FranCodeCafe/MeteorinoPi/meteorino/imgs/graficos/velocidad.jpg

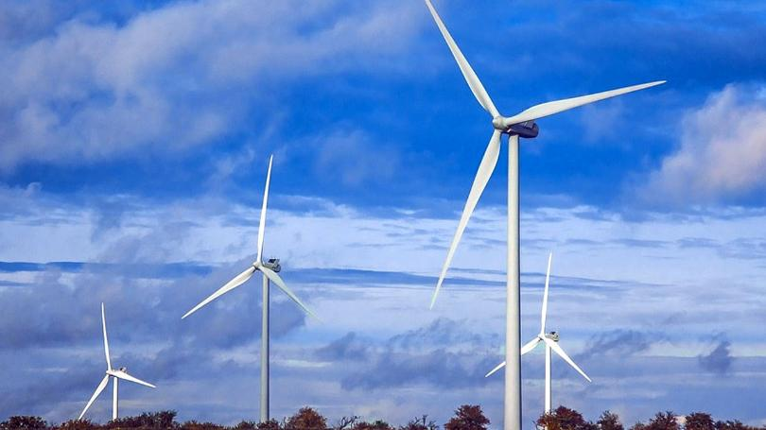
meteorino/imgs/graficos/velocidad.jpg
