FranCodeCafe/MeteorinoPi/Meteo_144458.png

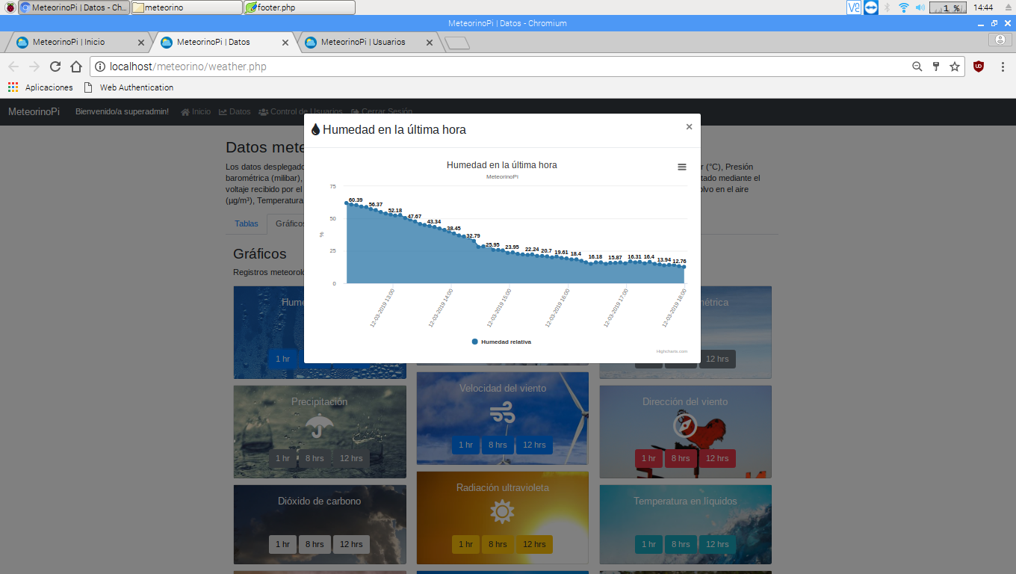
Meteo_144458.png
