FranCodeCafe/MeteorinoPi/Arduino1_1.jpg

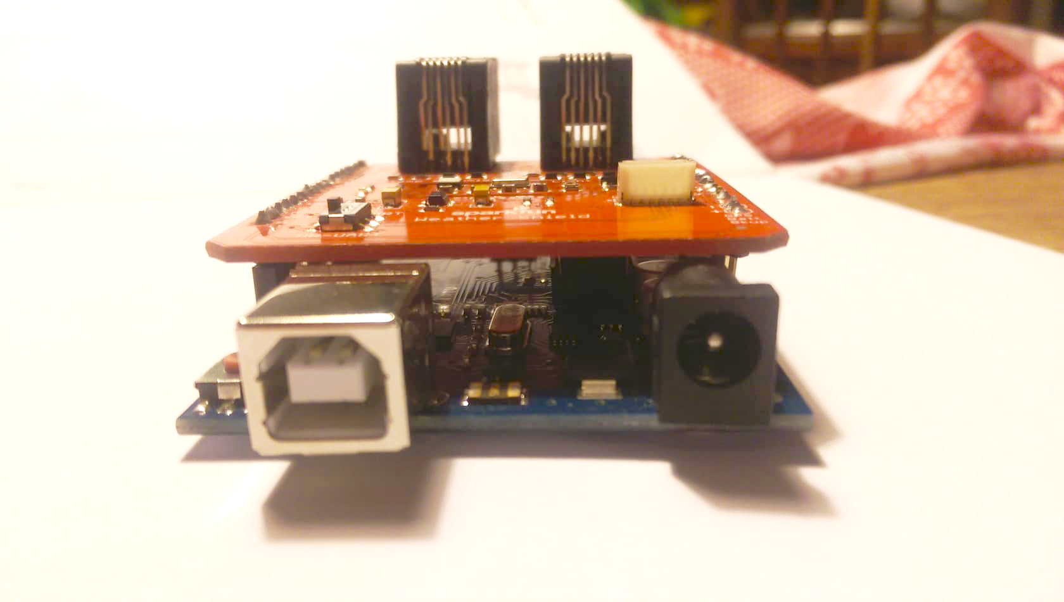
Arduino1_1.jpg
