FranCodeCafe/MeteorinoPi/Arduino1_2.jpg

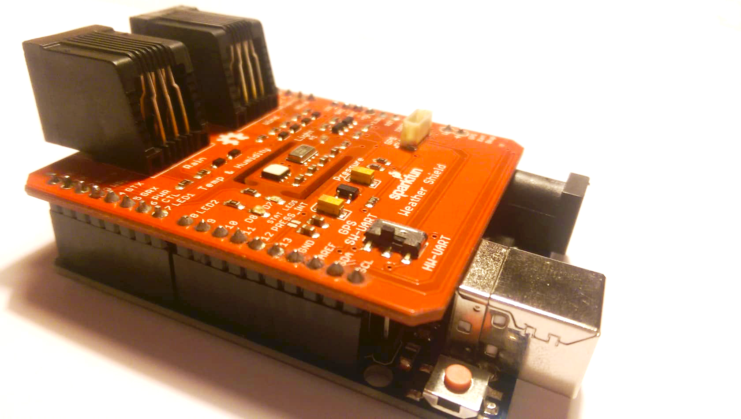
Arduino1_2.jpg
