FranCodeCafe/MeteorinoPi/Arduino2.png

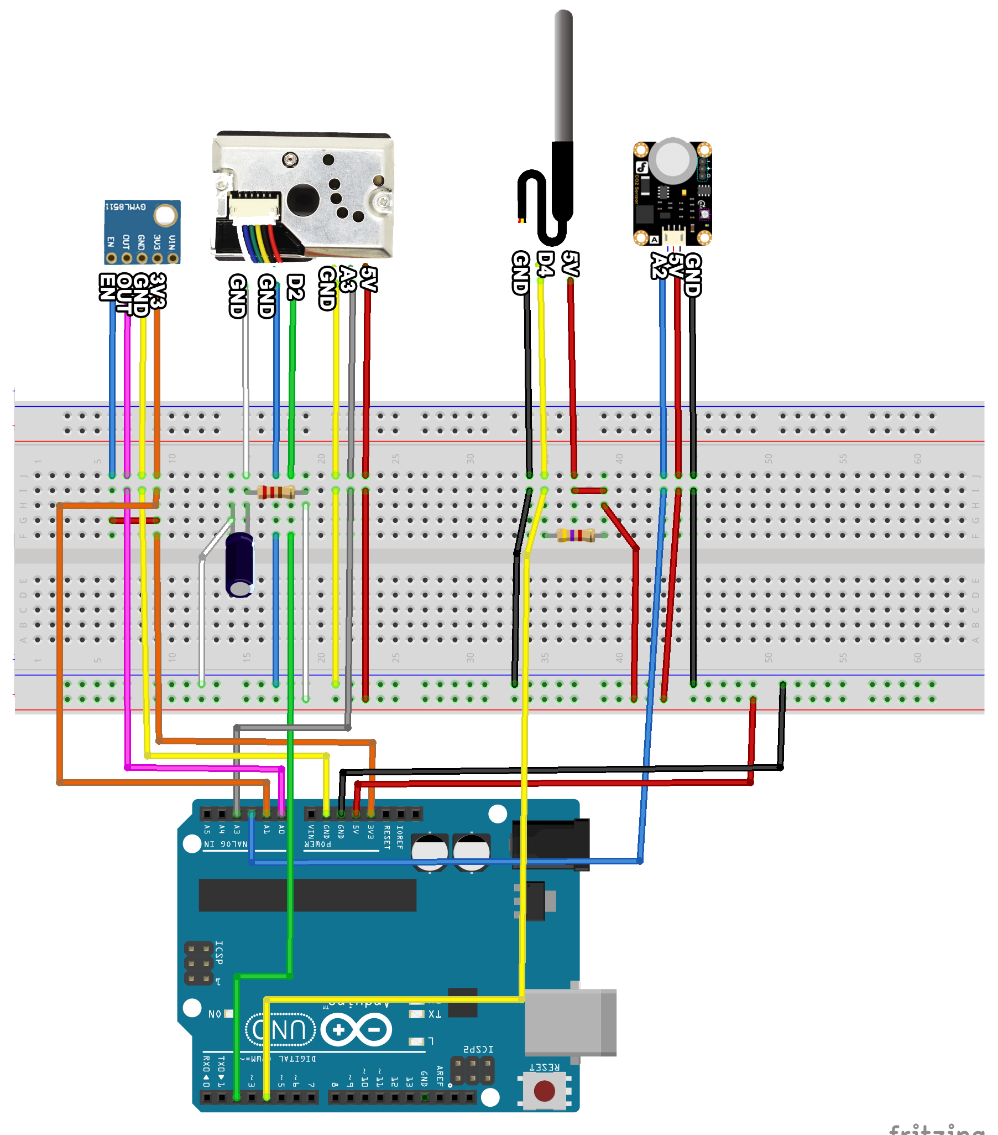
Arduino2.png
