FranCodeCafe/MeteorinoPi/Meteo_144257.png

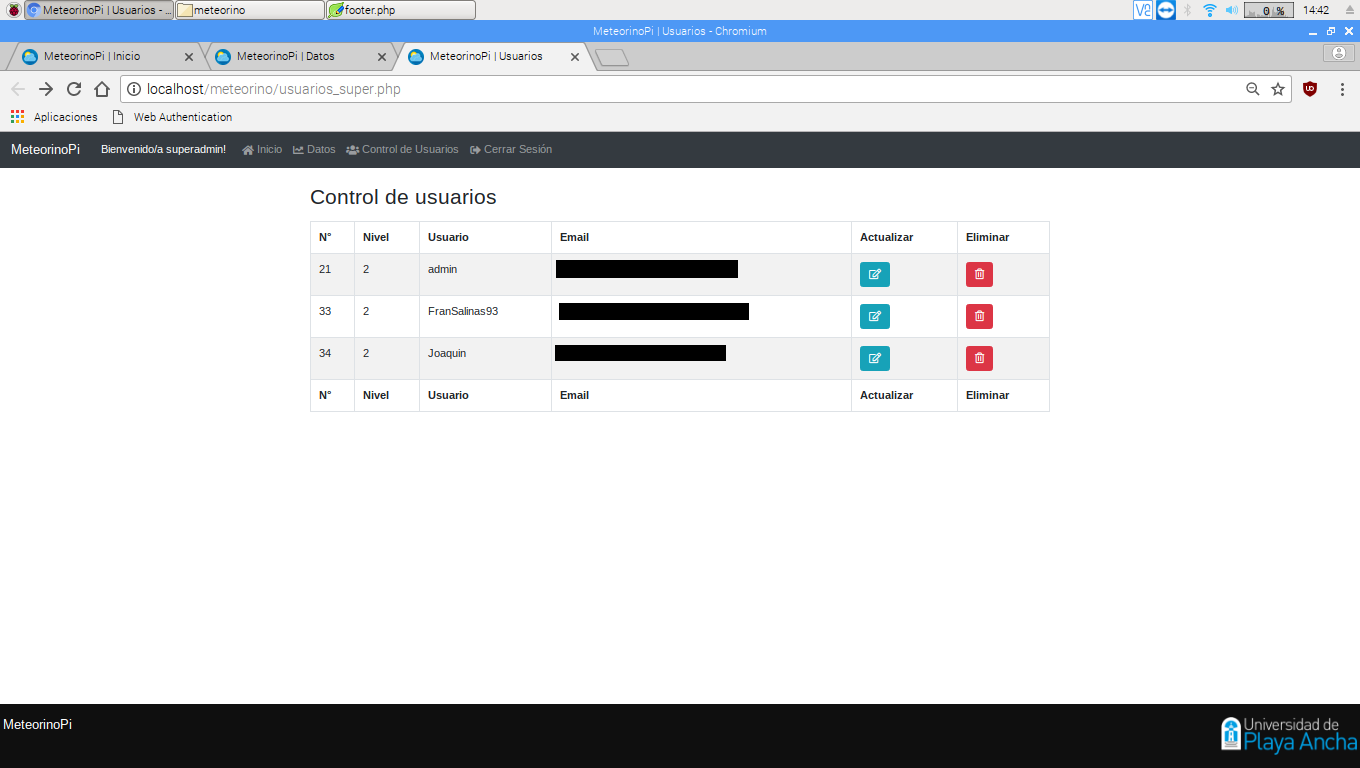
Meteo_144257.png
