FranCodeCafe/MeteorinoPi/Meteo_144417.png

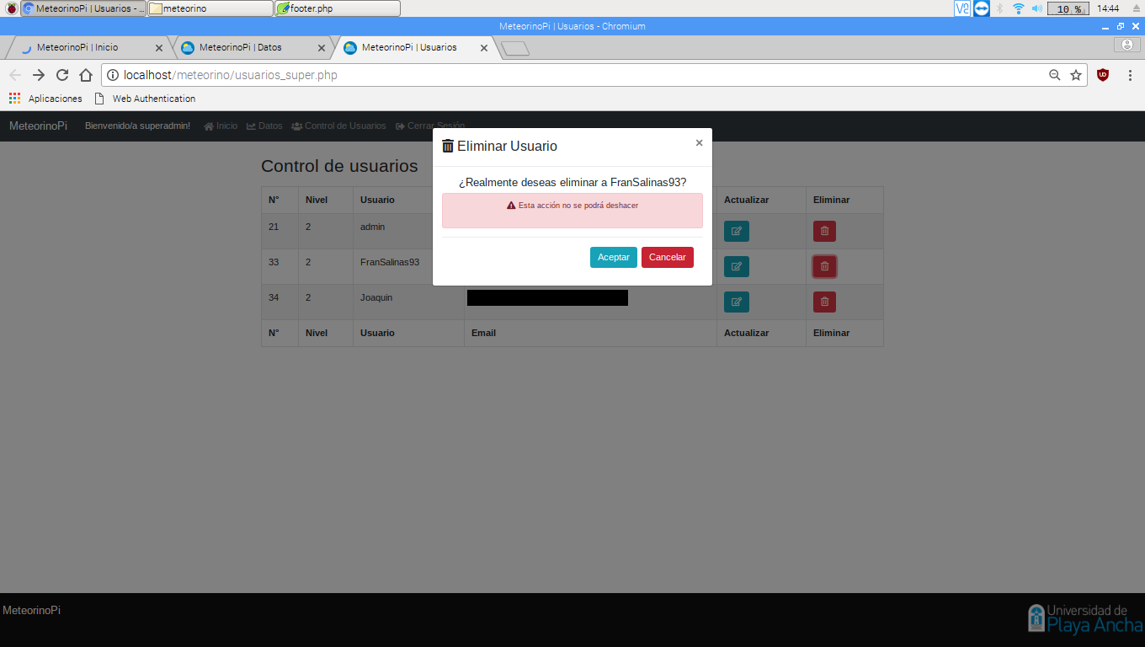
Meteo_144417.png
