FranCodeCafe/MeteorinoPi/Meteo_144430.png

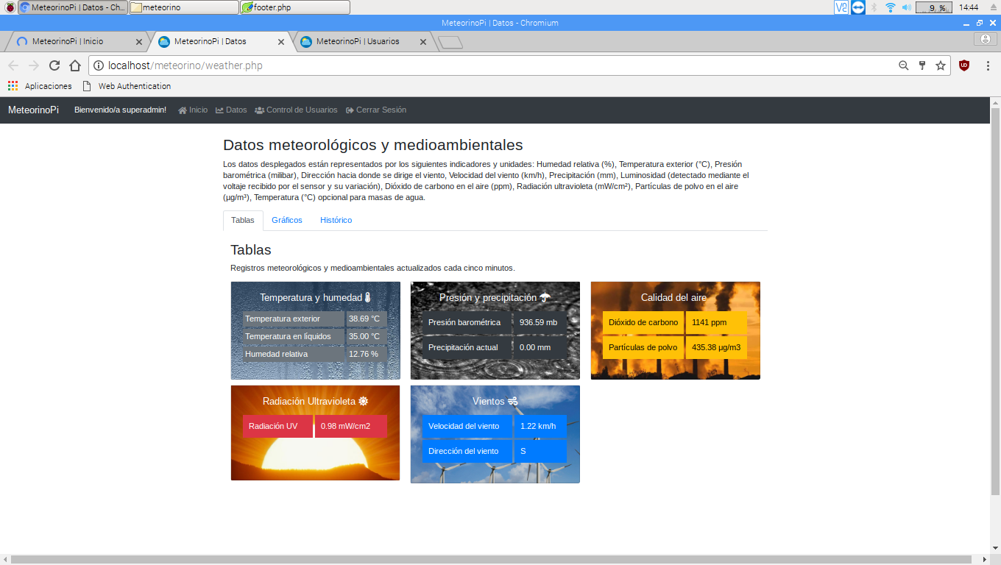
Meteo_144430.png
