FranCodeCafe/MeteorinoPi/Meteo_144438.png

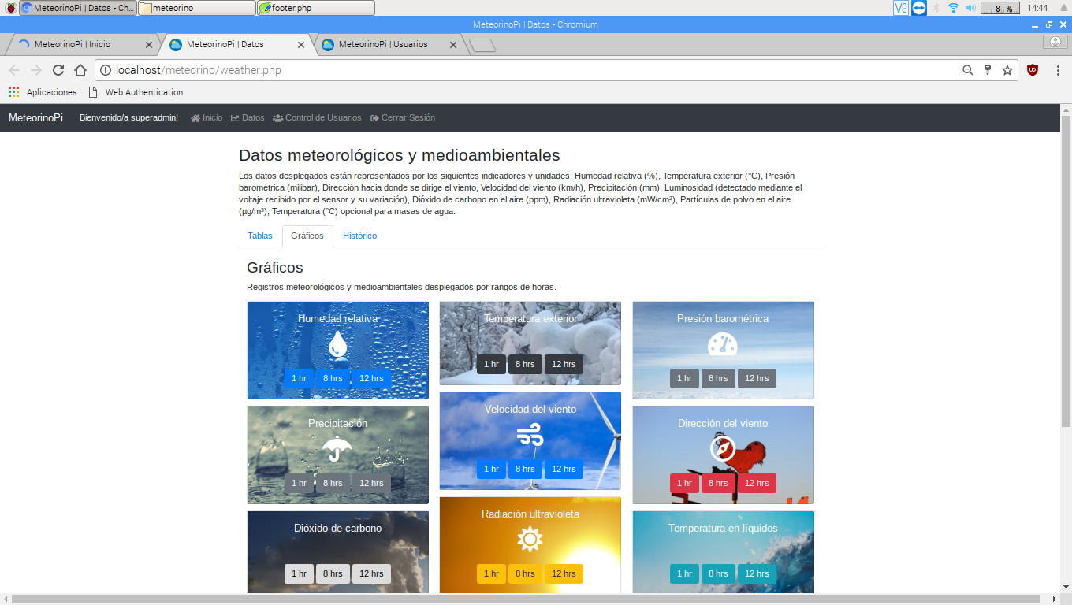
Meteo_144438.png
