FranCodeCafe/MeteorinoPi/Meteo_144442.png

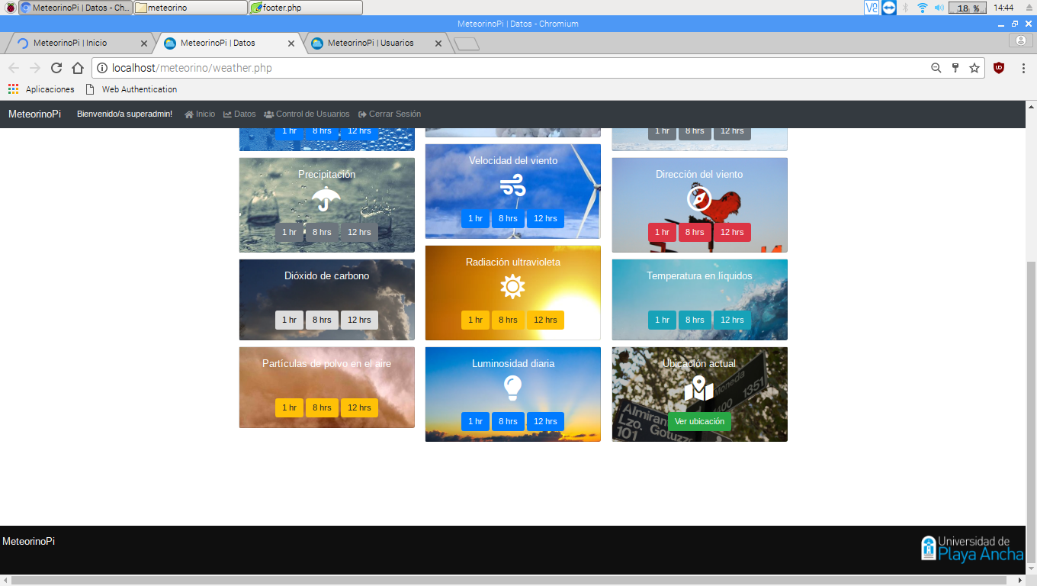
Meteo_144442.png
