FranCodeCafe/MeteorinoPi/Meteo_144524.png

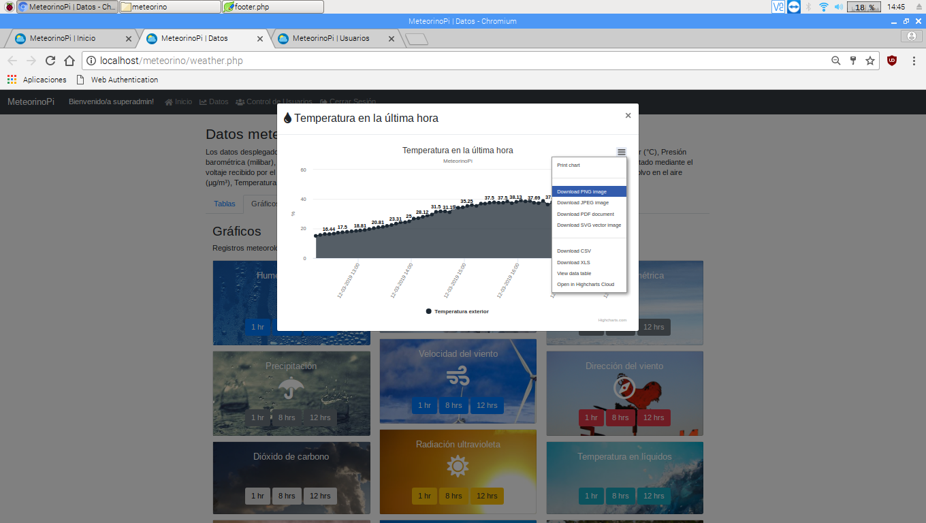
Meteo_144524.png
