FranCodeCafe/MeteorinoPi/Meteo_144529.png

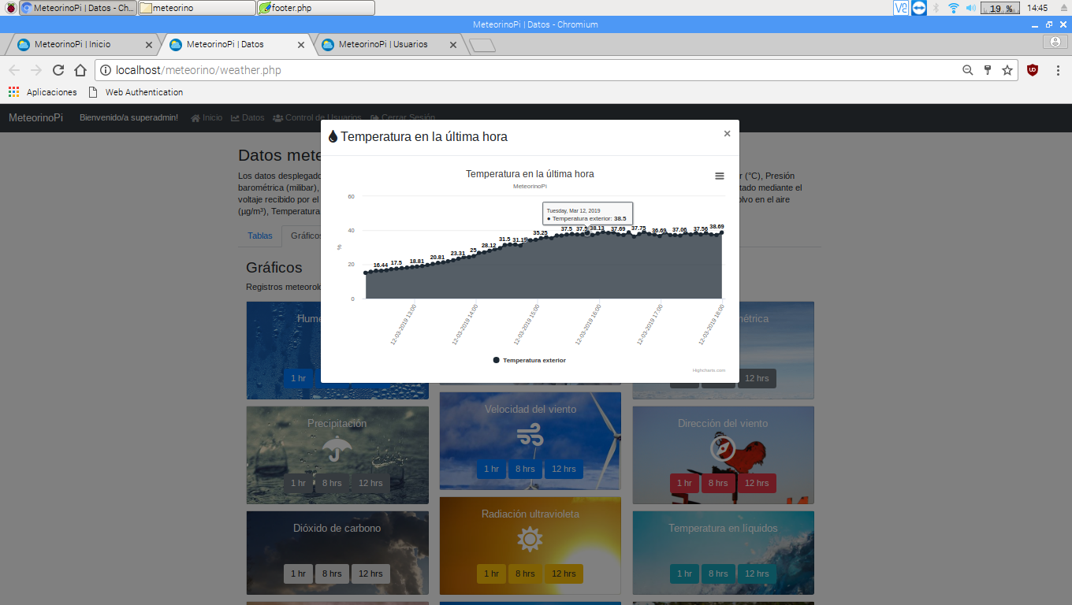
Meteo_144529.png
