FranCodeCafe/MeteorinoPi/Meteo_144618.png

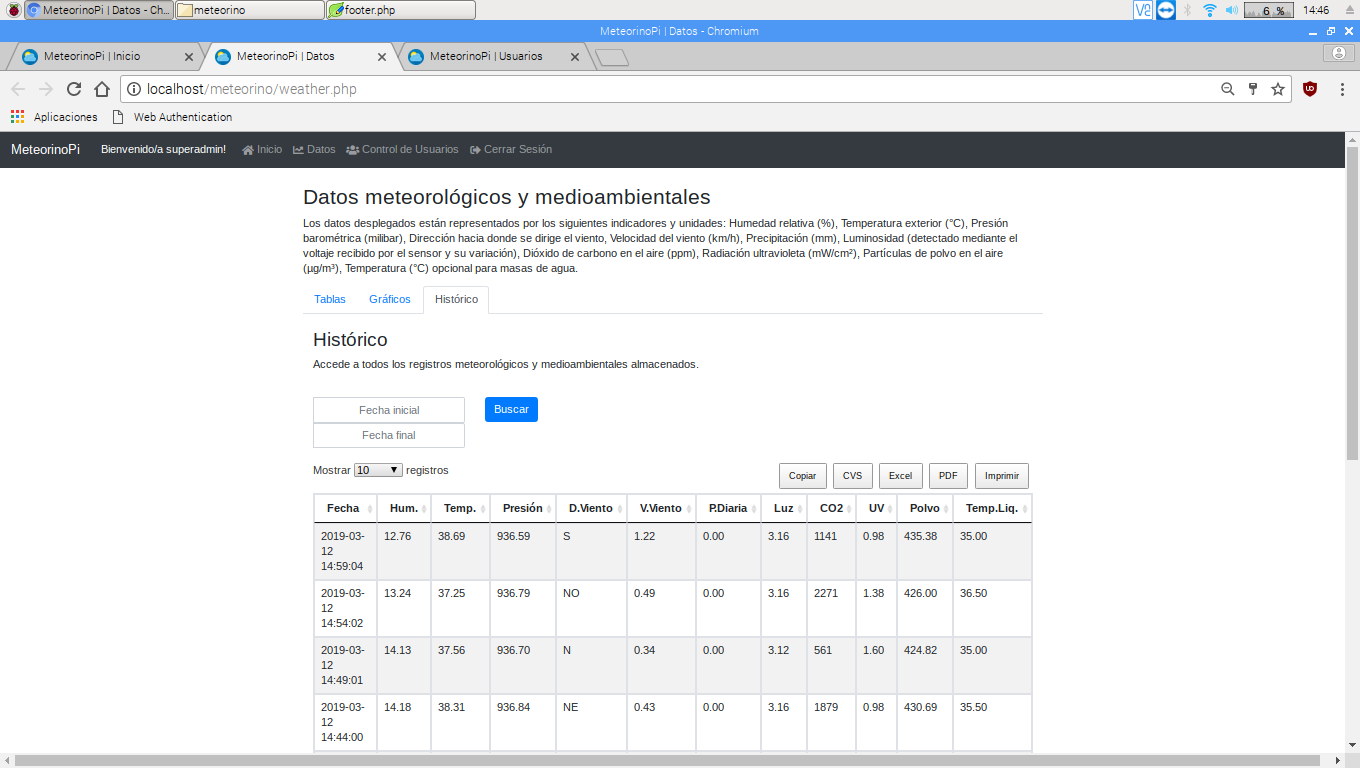
Meteo_144618.png
