FranCodeCafe/MeteorinoPi/Meteo_144702.png

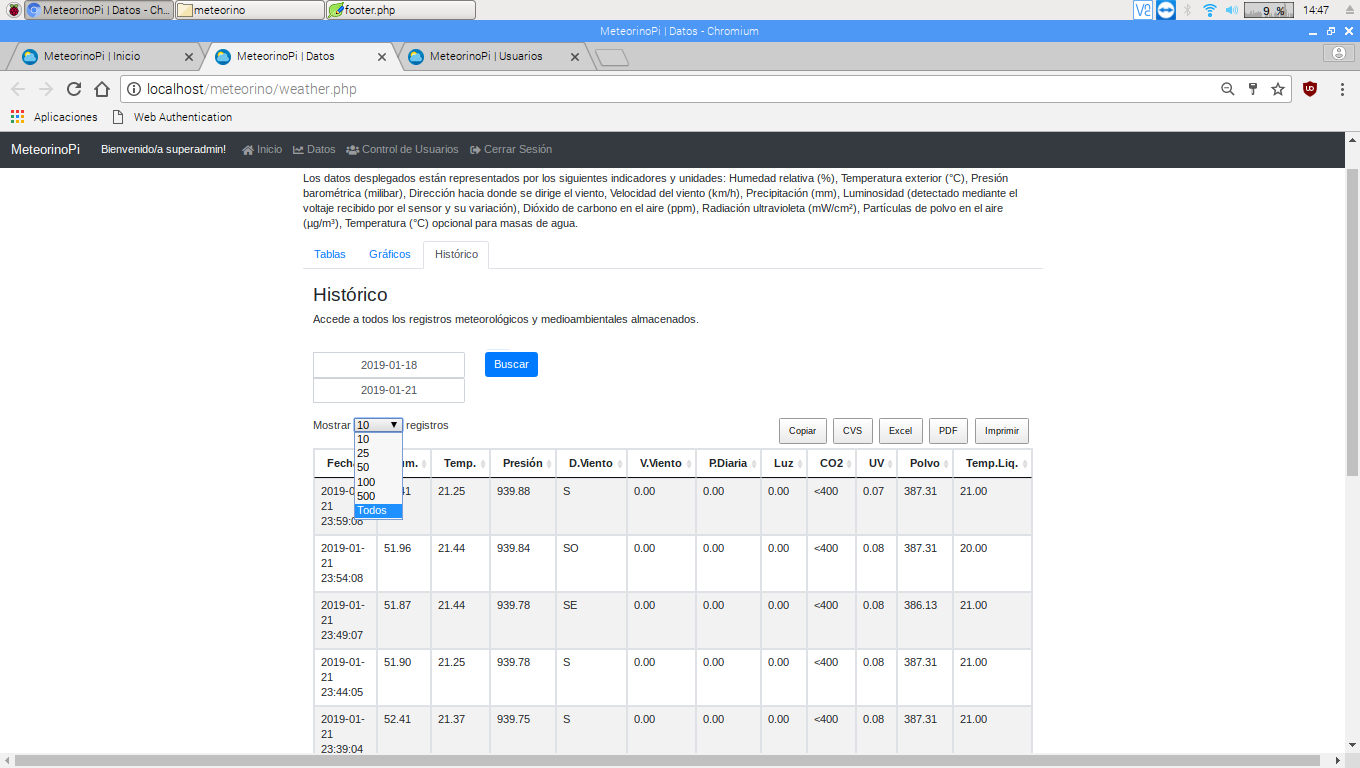
Meteo_144702.png
