FranCodeCafe/MeteorinoPi/Meteo_144732.png

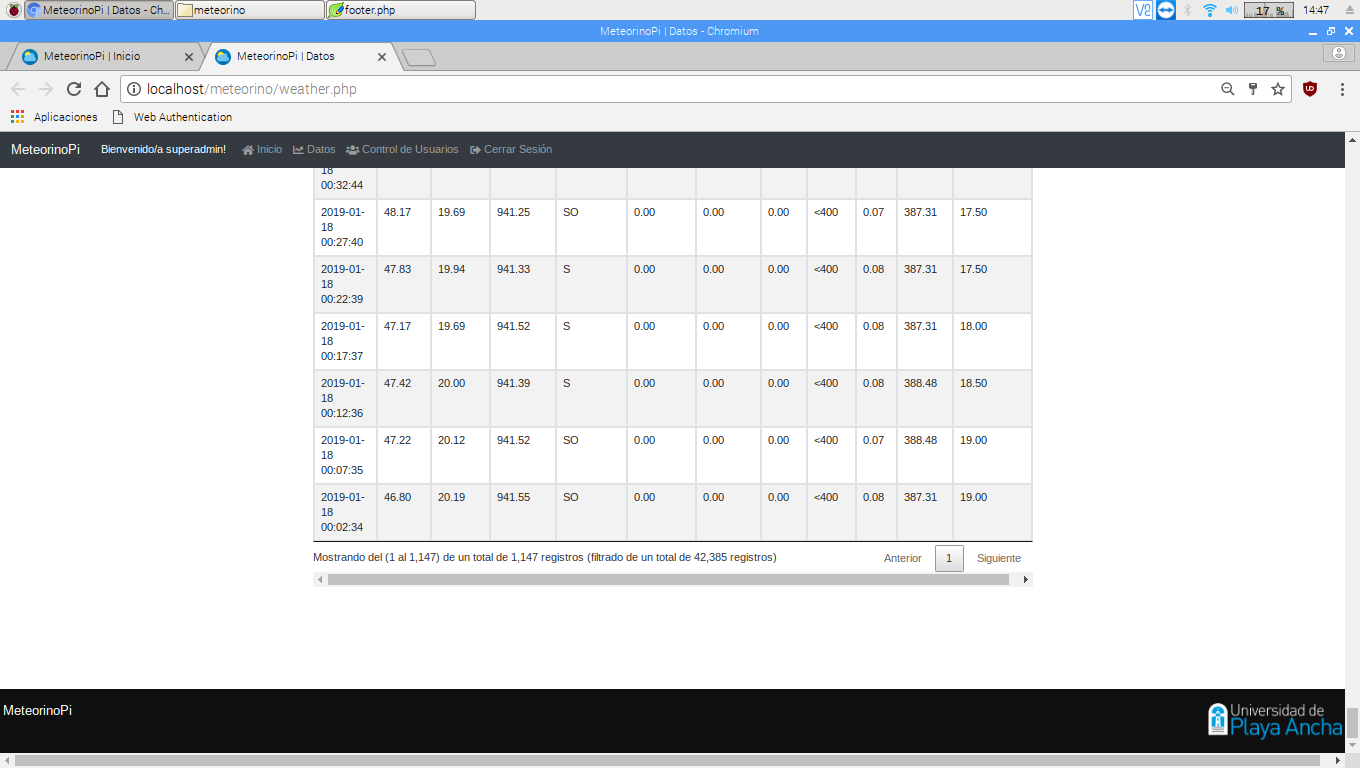
Meteo_144732.png
