FranCodeCafe/MeteorinoPi/Meteo_145000.png

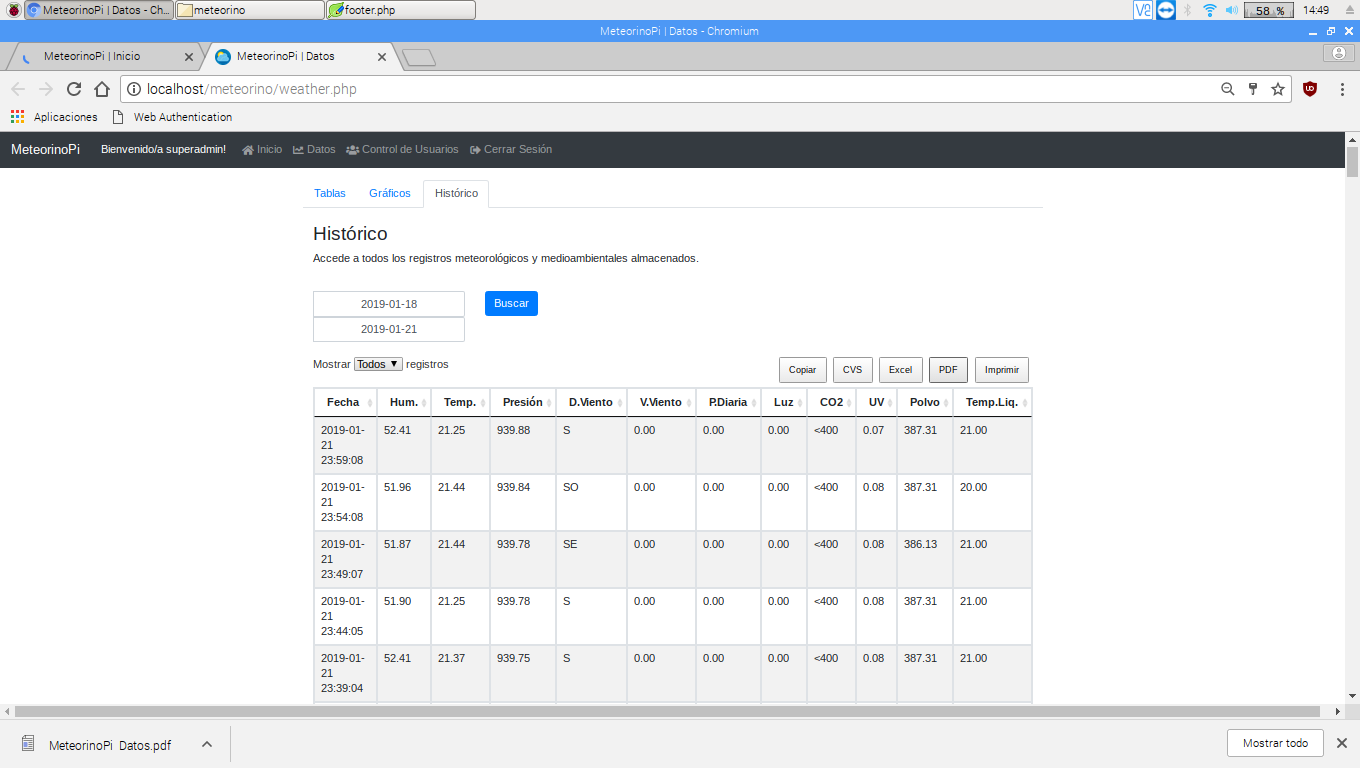
Meteo_145000.png
