FranCodeCafe/MeteorinoPi/Meteo_145024.png

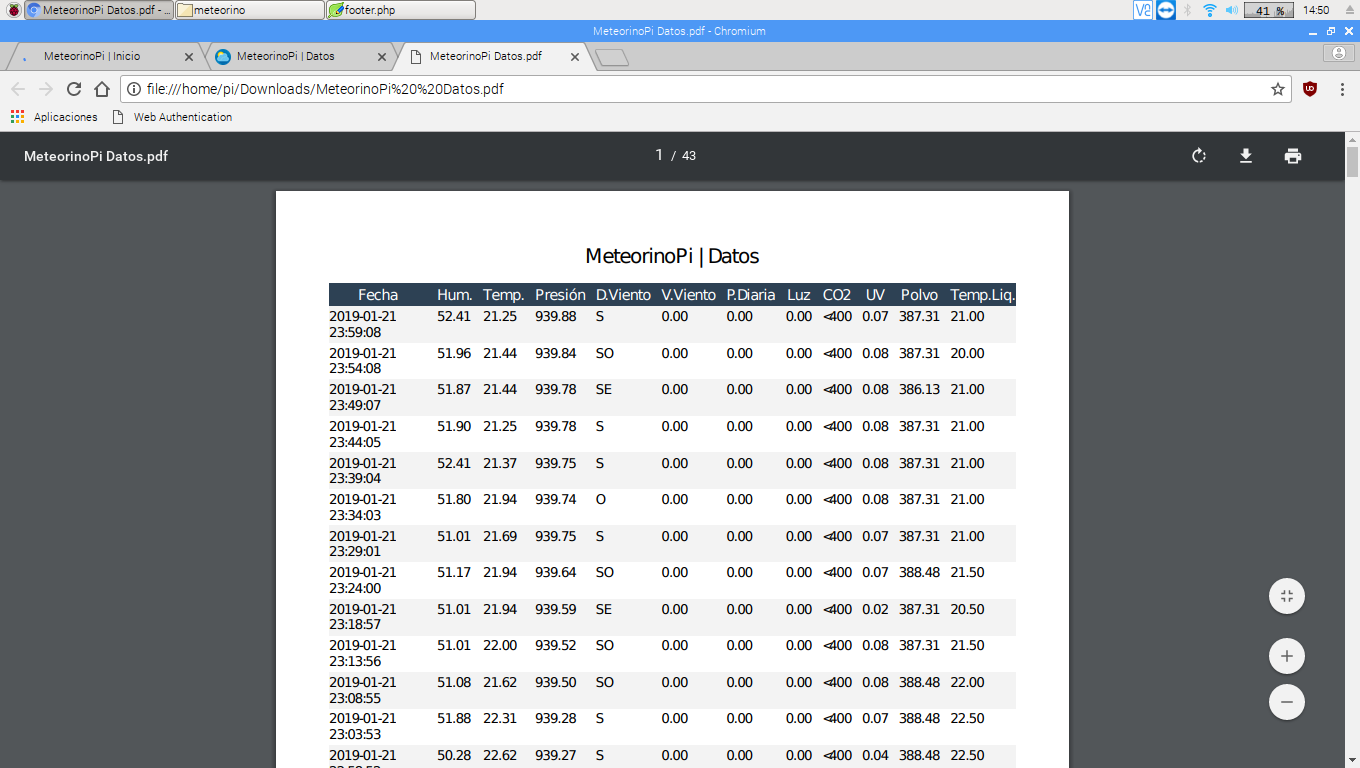
Meteo_145024.png
