FranCodeCafe/MeteorinoPi/Meteo_175026.png

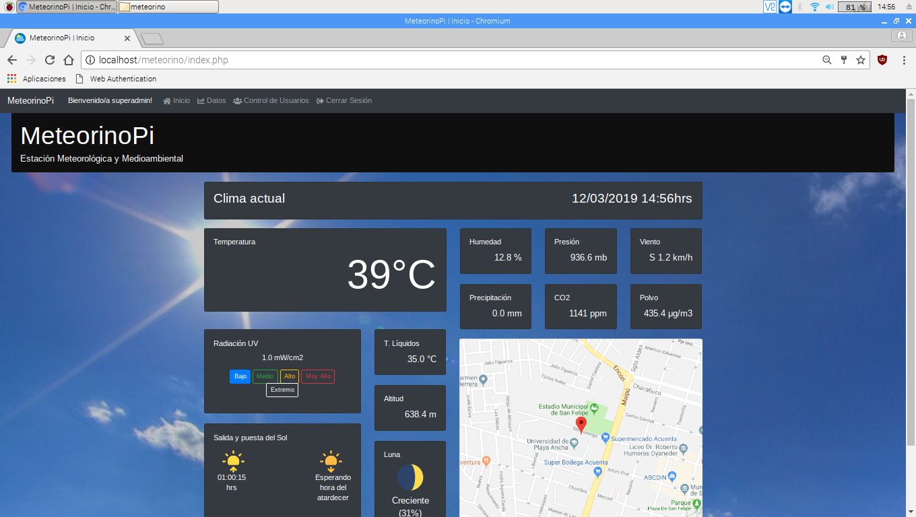
Meteo_175026.png
