FranCodeCafe/MeteorinoPi/Meteo_175029.png

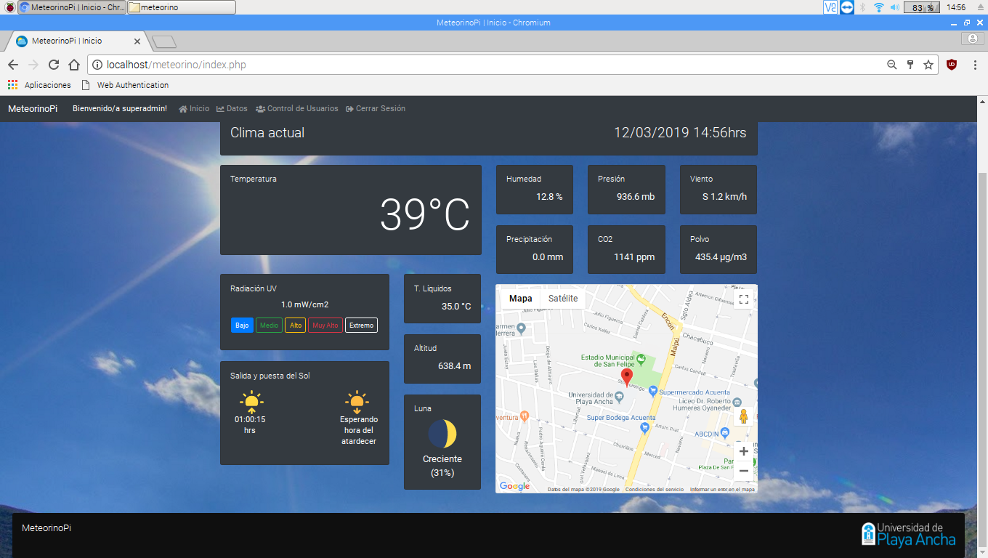
Meteo_175029.png
