FranCodeCafe/MeteorinoPi/Meteo_175746.png

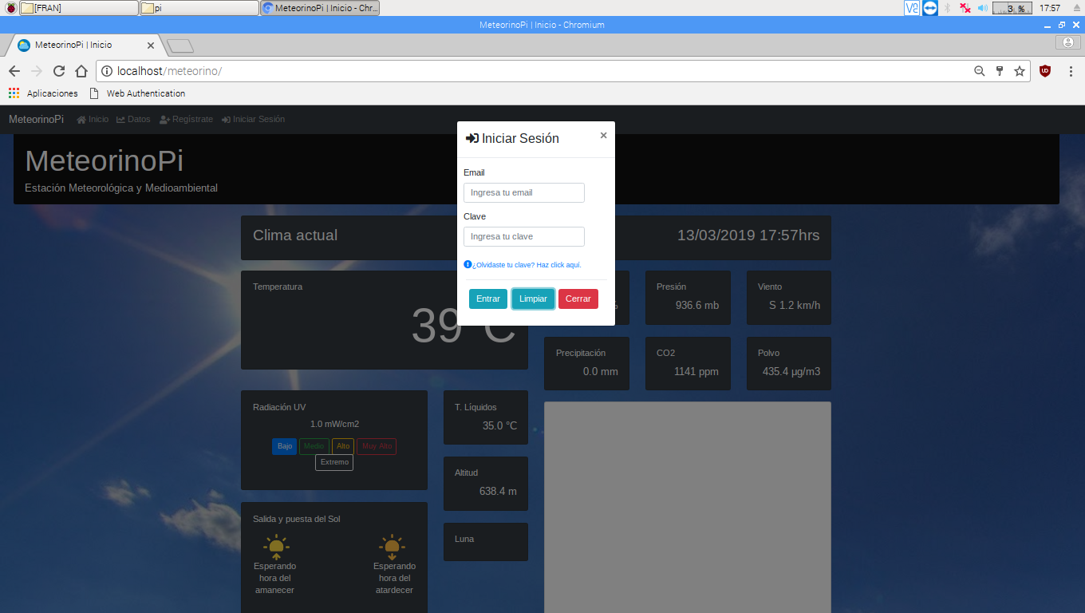
Meteo_175746.png
