FranCodeCafe/MeteorinoPi/meteorino/imgs/bgrainy.jpg

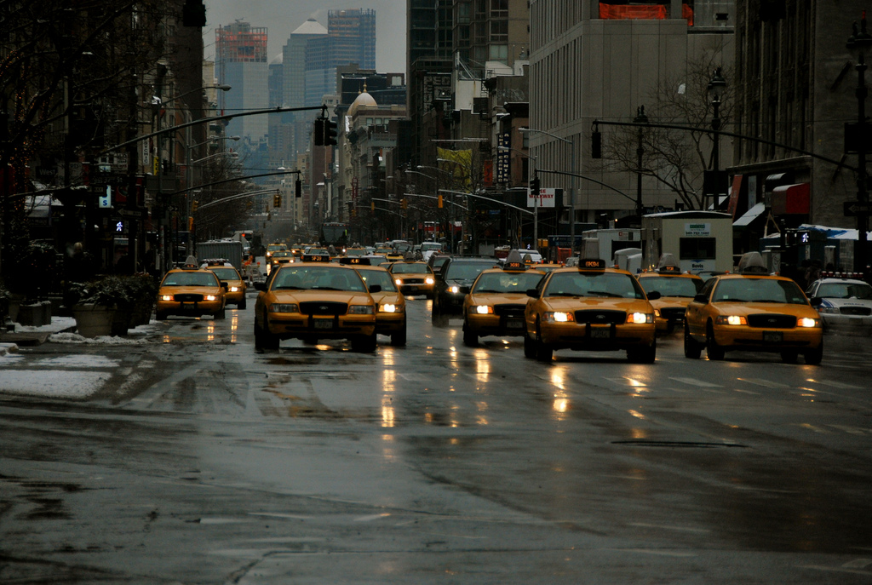
meteorino/imgs/bgrainy.jpg
