FranCodeCafe/MeteorinoPi/meteorino/imgs/graficos/agua.jpg

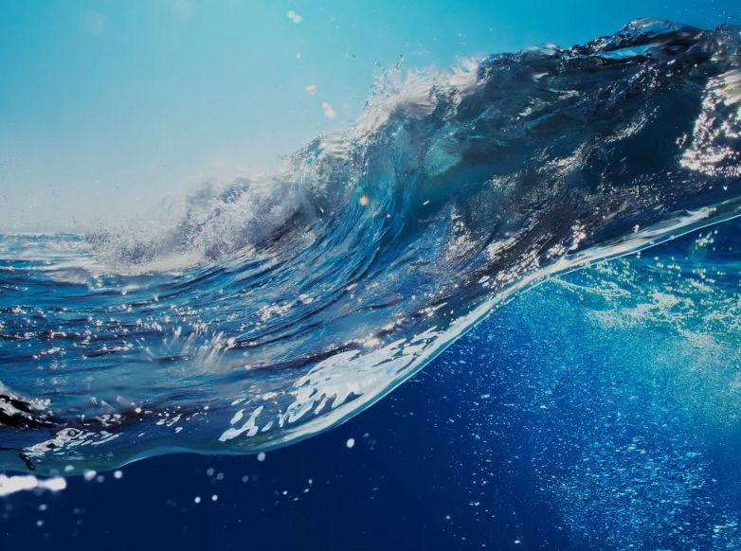
meteorino/imgs/graficos/agua.jpg
