FranCodeCafe/MeteorinoPi/meteorino/imgs/graficos/agua.png

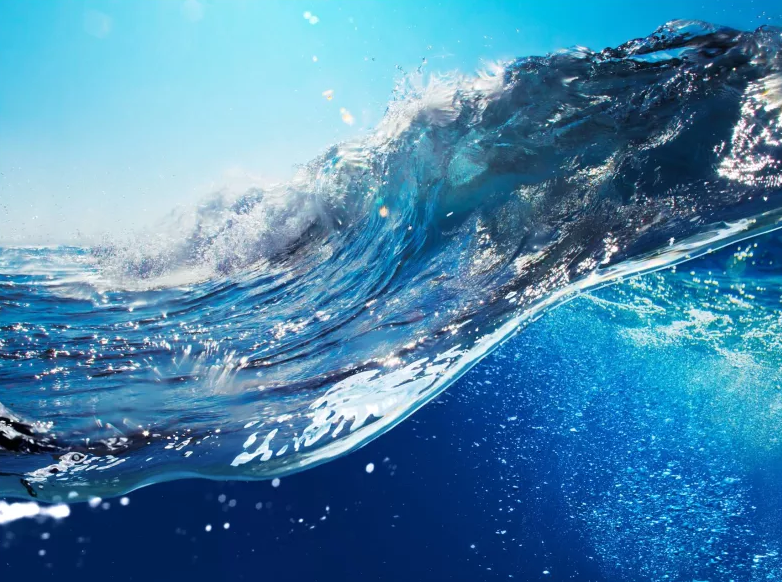
meteorino/imgs/graficos/agua.png
