FranCodeCafe/MeteorinoPi/meteorino/imgs/graficos/co2.jpg

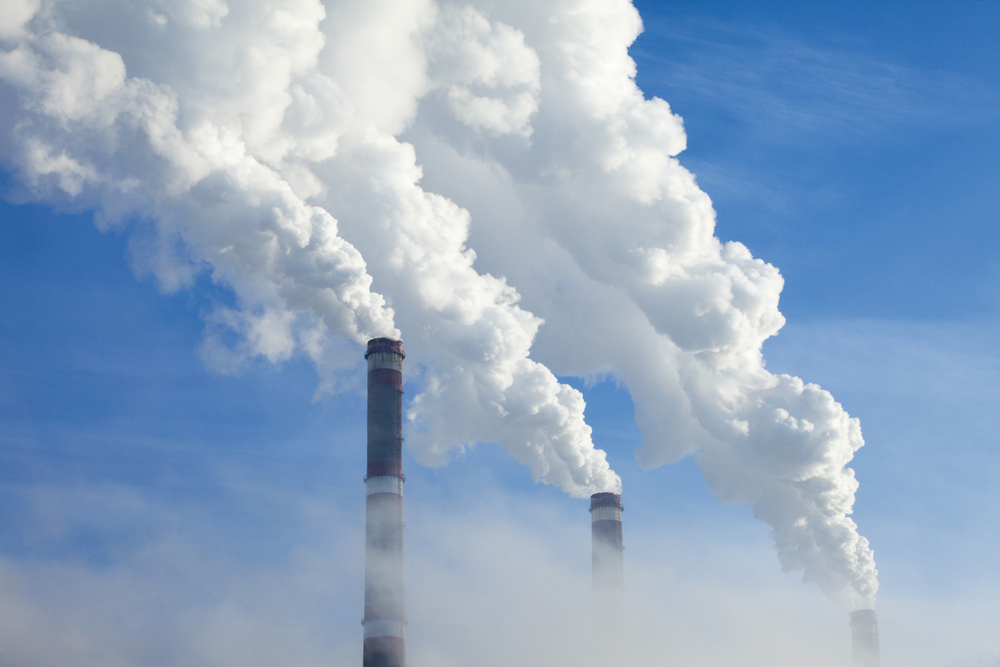
meteorino/imgs/graficos/co2.jpg
