FranCodeCafe/MeteorinoPi/meteorino/imgs/graficos/co2.png

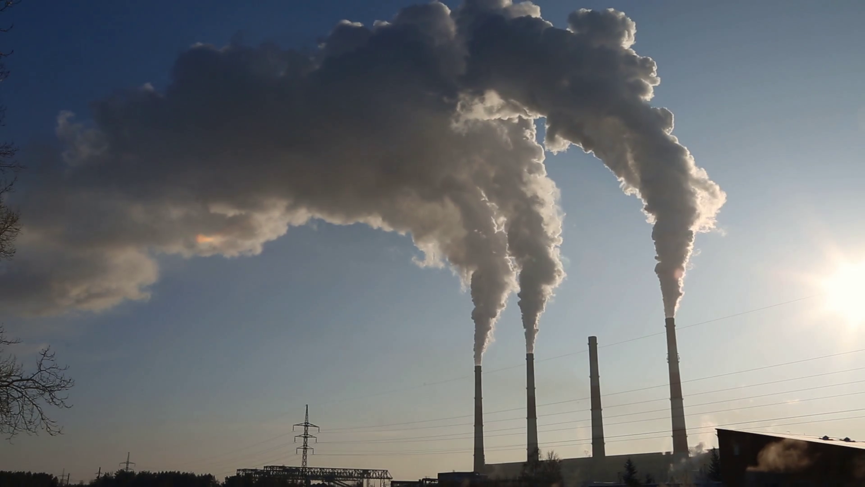
meteorino/imgs/graficos/co2.png
