FranCodeCafe/MeteorinoPi/meteorino/imgs/graficos/direccion.jpg

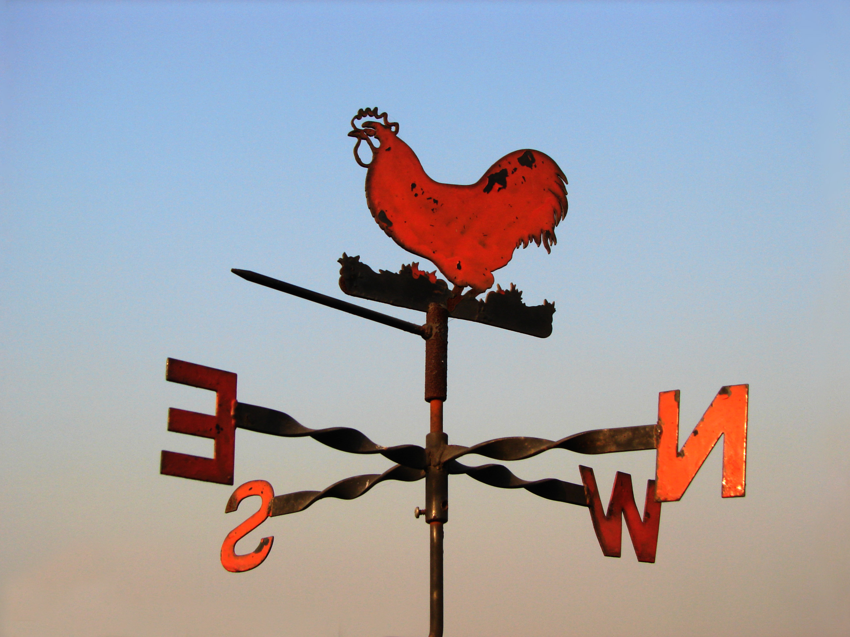
meteorino/imgs/graficos/direccion.jpg
