FranCodeCafe/MeteorinoPi/meteorino/imgs/graficos/gps.jpg

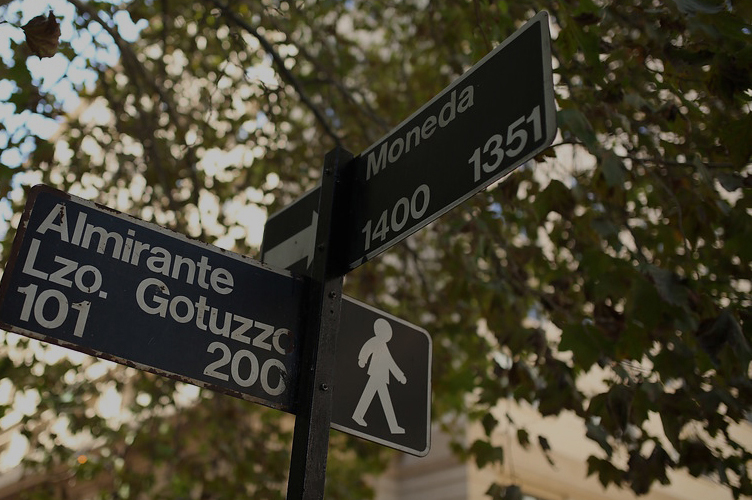
meteorino/imgs/graficos/gps.jpg
