FranCodeCafe/MeteorinoPi/meteorino/imgs/graficos/humedad.jpg

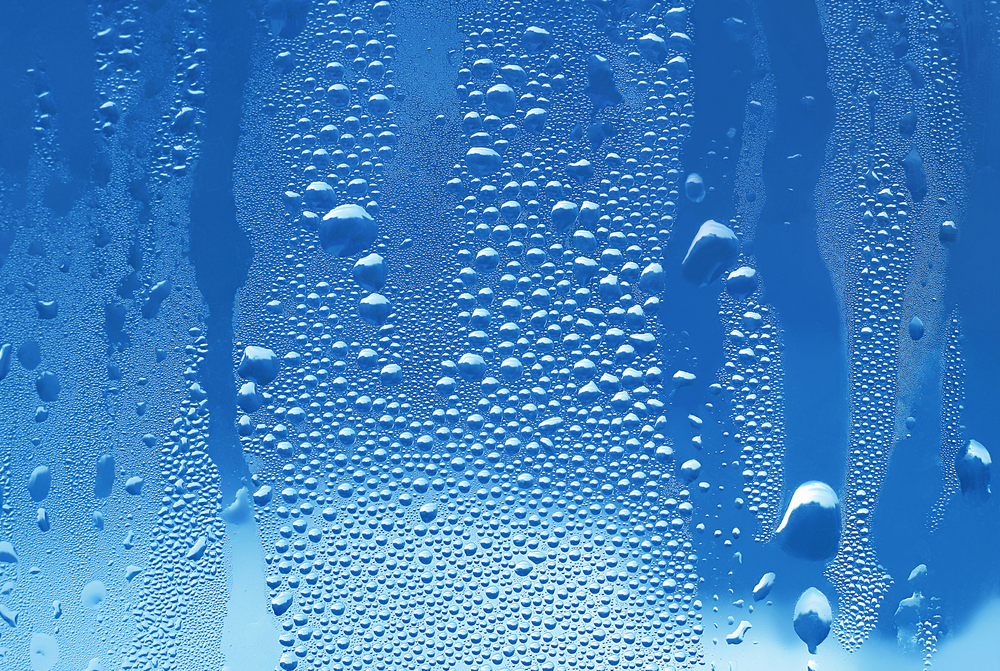
meteorino/imgs/graficos/humedad.jpg
