FranCodeCafe/MeteorinoPi/meteorino/imgs/graficos/lluvia.jpg

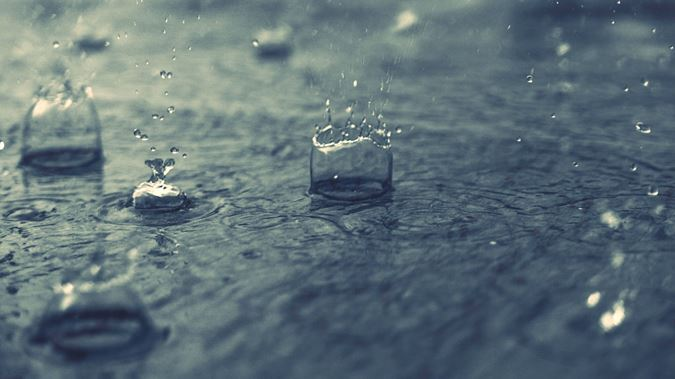
meteorino/imgs/graficos/lluvia.jpg
