FranCodeCafe/MeteorinoPi/meteorino/imgs/graficos/luz.jpg

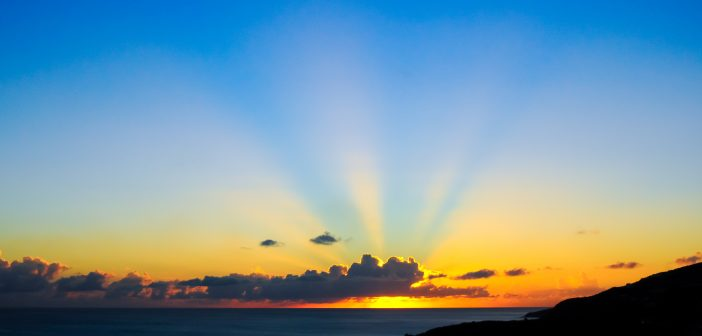
meteorino/imgs/graficos/luz.jpg
