FranCodeCafe/MeteorinoPi/meteorino/imgs/graficos/polvo.jpg

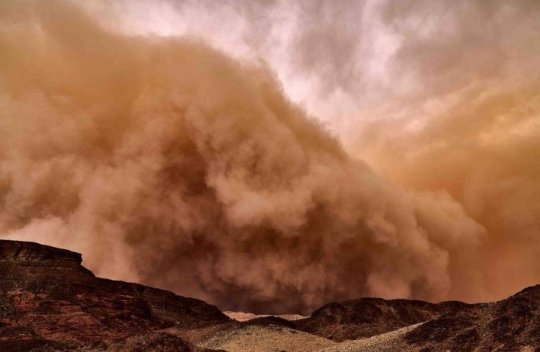
meteorino/imgs/graficos/polvo.jpg
