FranCodeCafe/MeteorinoPi/meteorino/imgs/graficos/presion.png

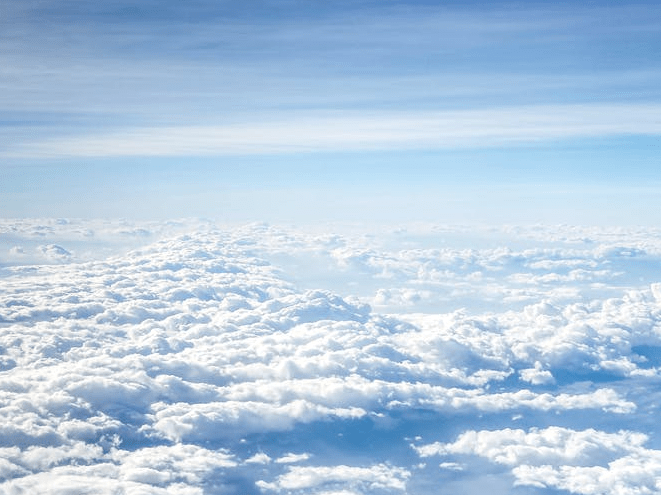
meteorino/imgs/graficos/presion.png
