FranCodeCafe/MeteorinoPi/meteorino/imgs/nubes.jpg

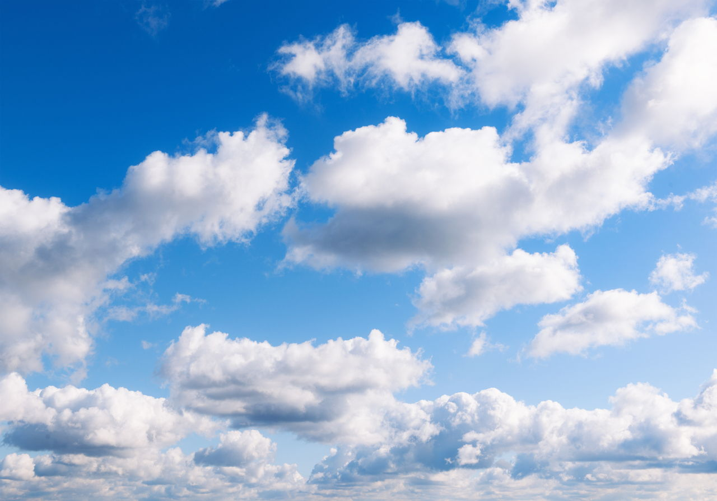
meteorino/imgs/nubes.jpg
