FranCodeCafe/MeteorinoPi/meteorino/imgs/tablas/humedad.jpg

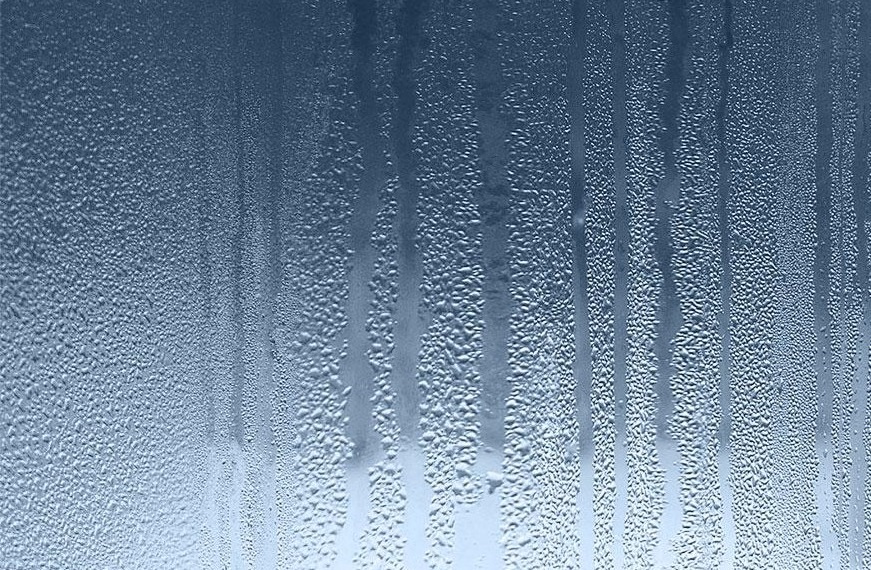
meteorino/imgs/tablas/humedad.jpg
