FranCodeCafe/MeteorinoPi/meteorino/imgs/tablas/lluvia.jpg

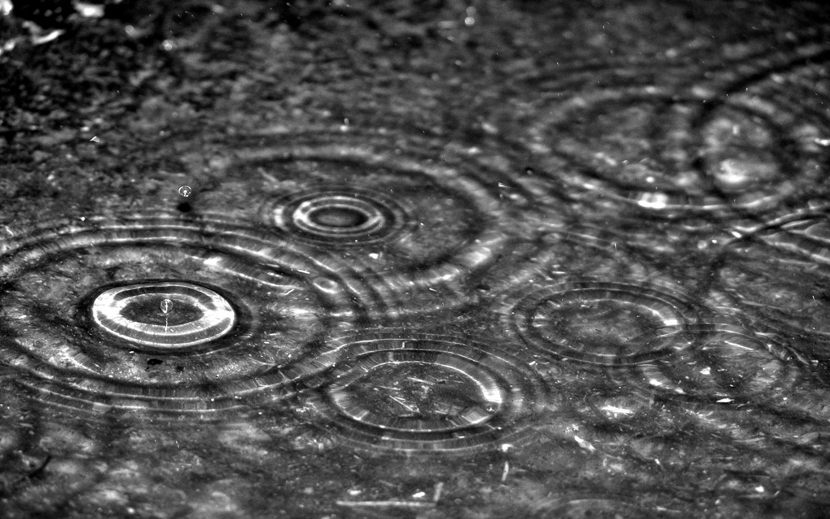
meteorino/imgs/tablas/lluvia.jpg
