FranCodeCafe/MeteorinoPi/meteorino/imgs/tablas/polvo.png

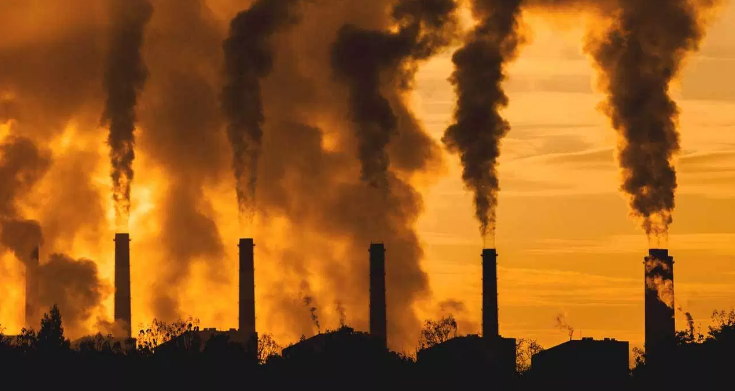
meteorino/imgs/tablas/polvo.png
