FranCodeCafe/MeteorinoPi/meteorino/imgs/tablas/vientos2.jpg

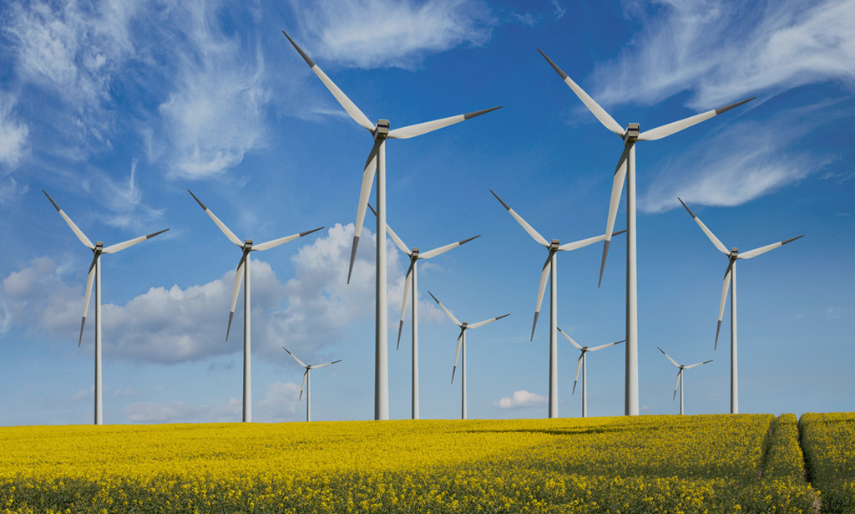
meteorino/imgs/tablas/vientos2.jpg
