FranCodeCafe/MeteorinoPi/meteorino/imgs/upla.png

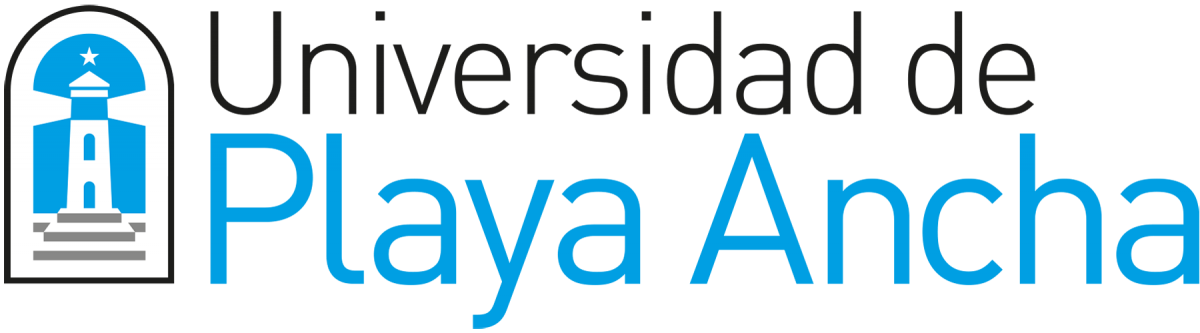
meteorino/imgs/upla.png
