FranCodeCafe/MeteorinoPi/meteorino/imgs/upla_blanco.png

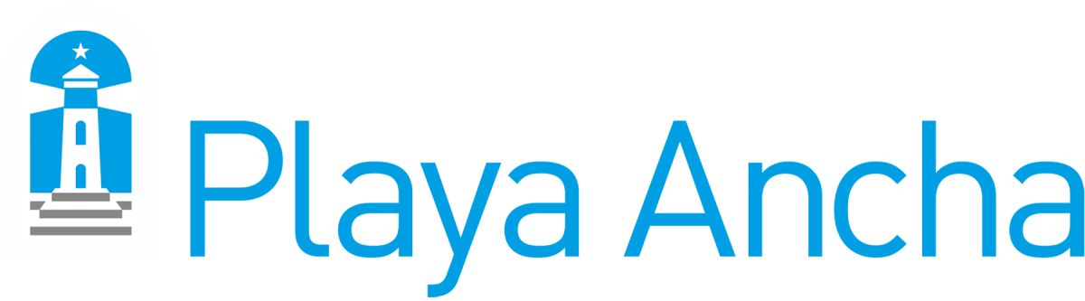
meteorino/imgs/upla_blanco.png
