FranCodeCafe/MeteorinoPi/Meteorino_1.jpg

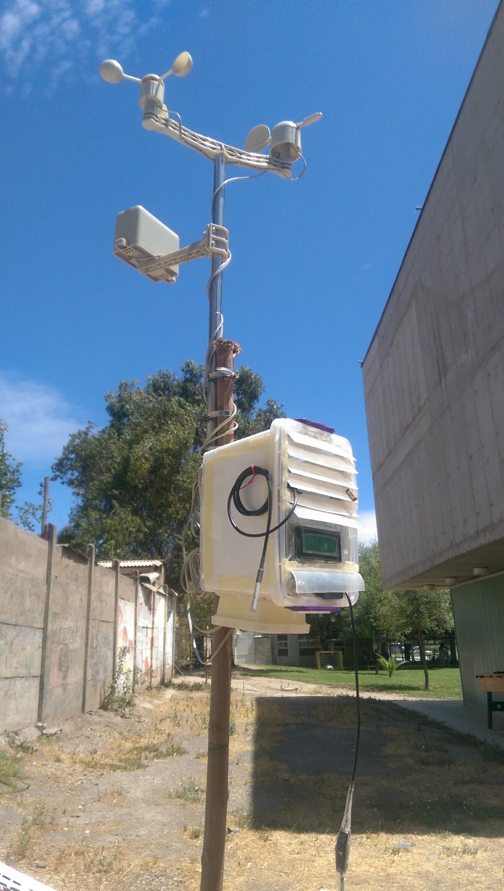
Meteorino_1.jpg
