FranCodeCafe/MeteorinoPi/Meteorino_2.jpg

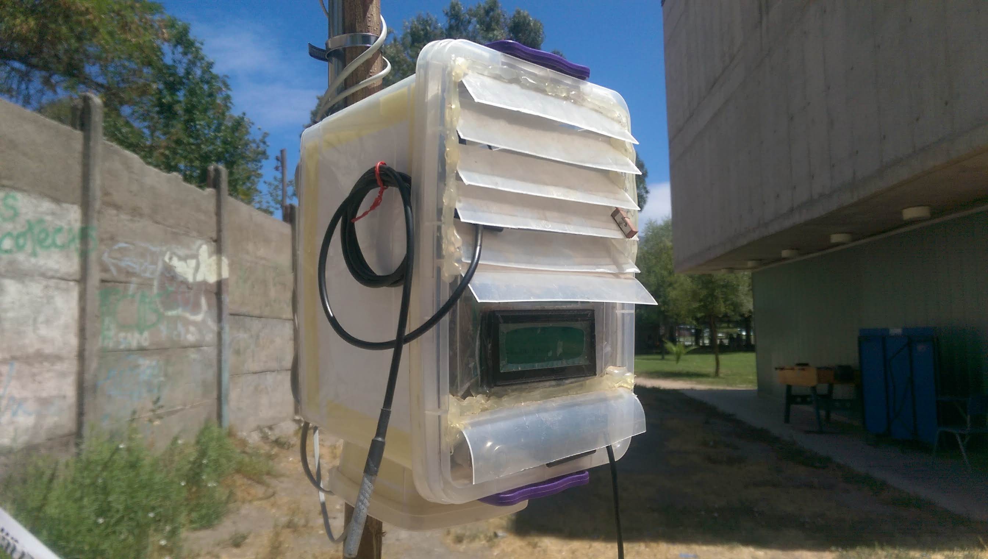
Meteorino_2.jpg
