FranCodeCafe/MeteorinoPi/RasPi.png

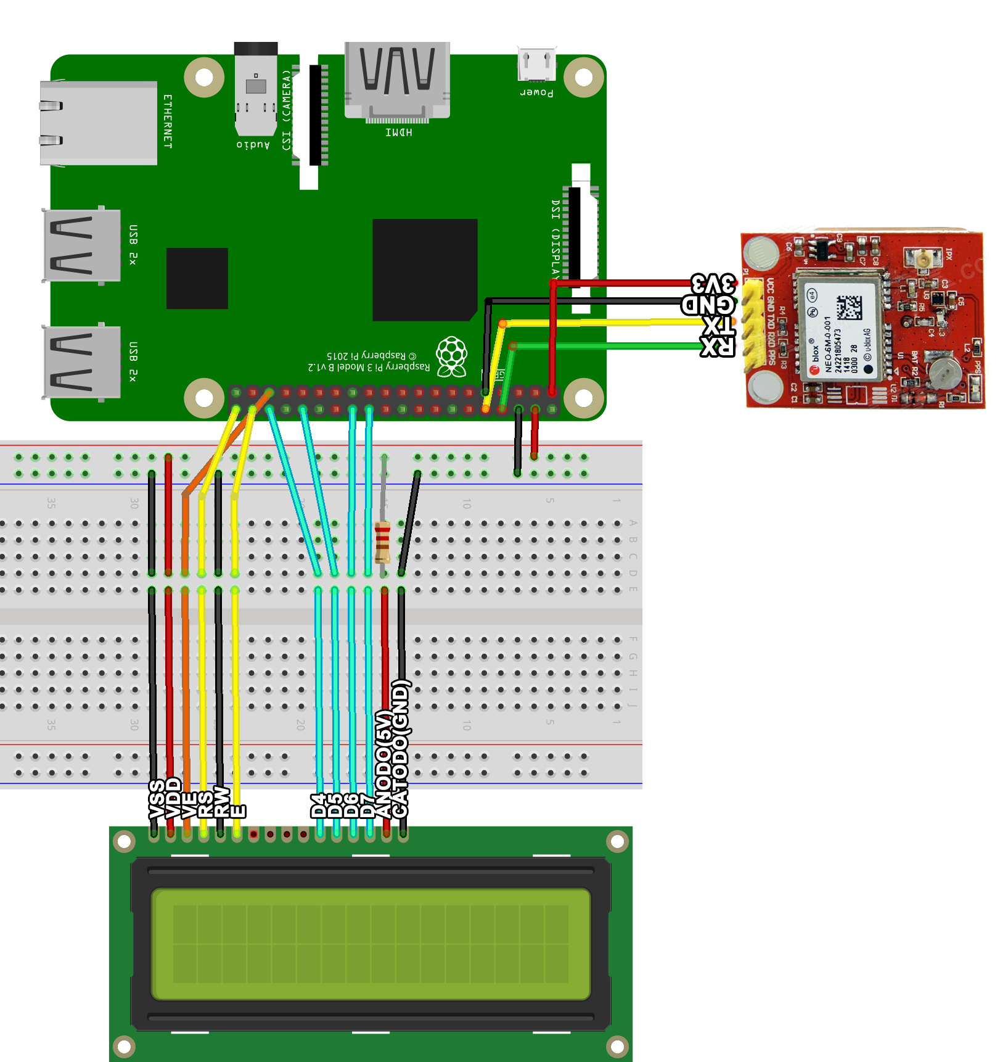
RasPi.png
